engr110-2026-obstacle-detector/pcb/front/renders/front_back.png

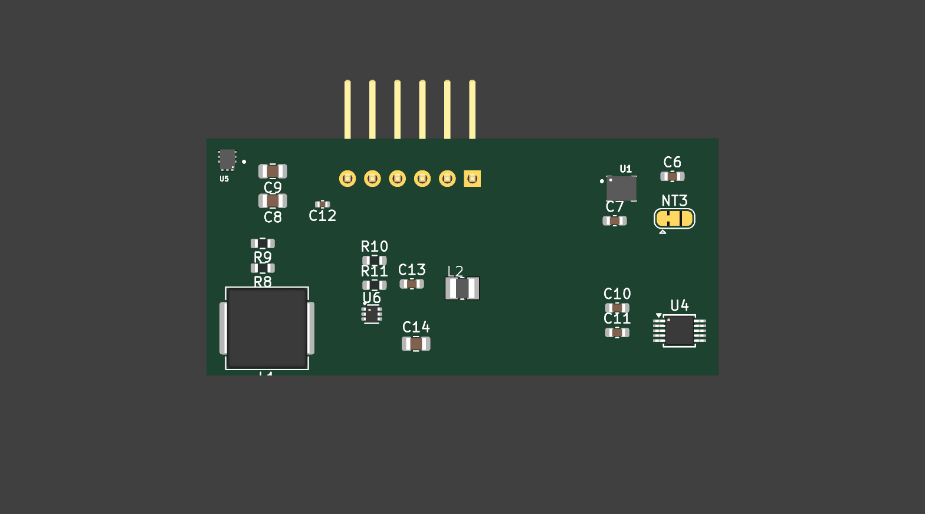
front/renders/front_back.png
