engr110-2026-obstacle-detector/pcb/front/renders/front_sensor_C.png

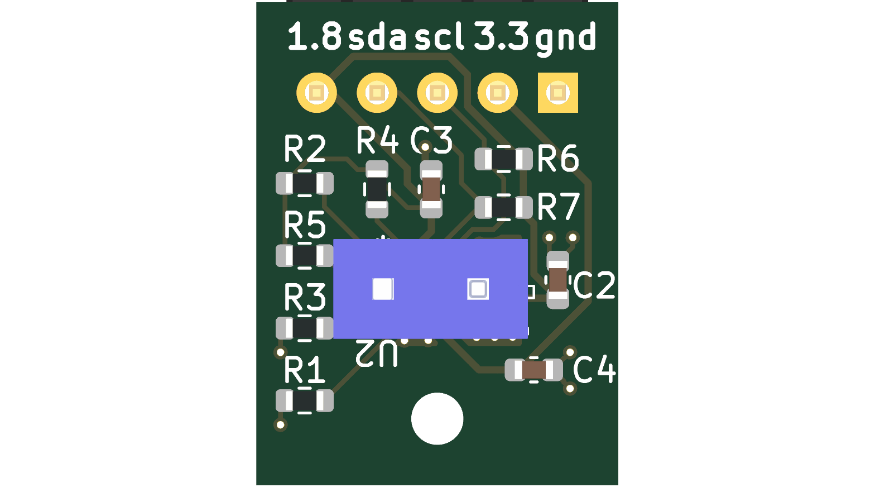
front/renders/front_sensor_C.png
