engr110-2026-obstacle-detector/pcb/front/renders/front_top.png

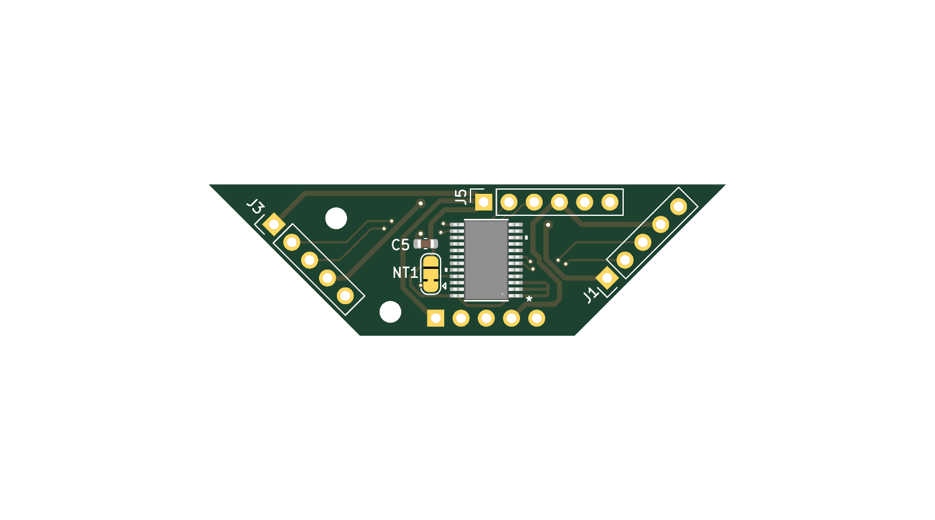
front/renders/front_top.png
