engr110-2026-obstacle-detector/pcb/front/renders/panel.png

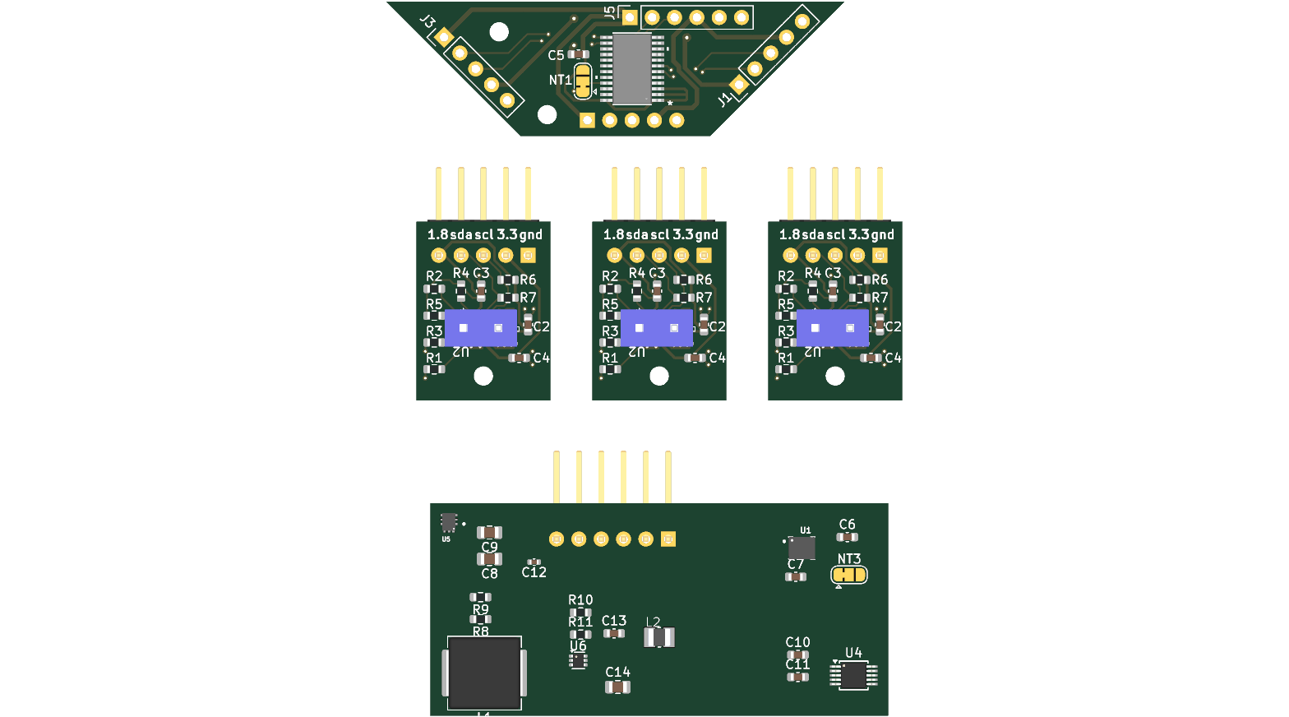
front/renders/panel.png
