engr110-2026-obstacle-detector/pcb/front/3d_models/front_assembly.step

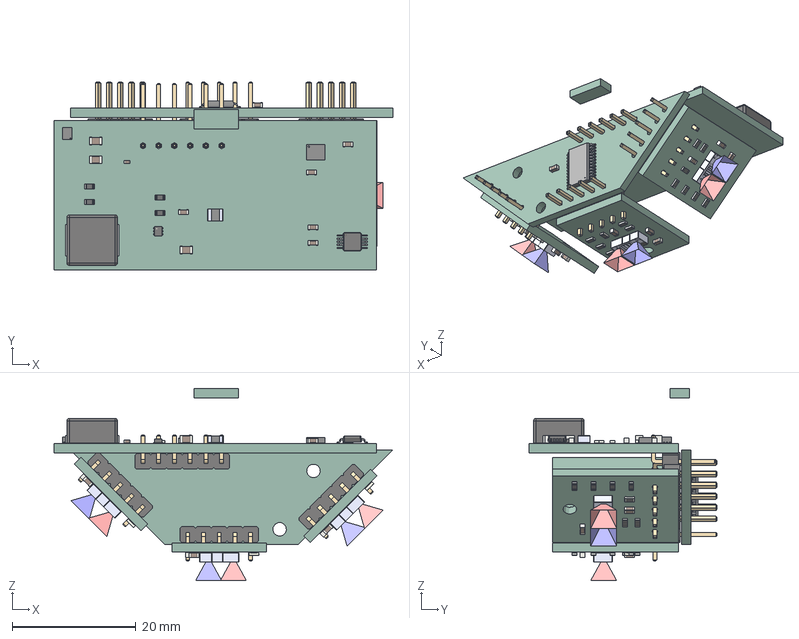
[picture p5: CAD file, 2026-04-03]
front/3d_models/front_assembly.step
54.7 x 30.4 x 31.0 mm
C_0603_1608Metric x 15
TSSOP-10_3x3mm_P0.5mm
SOT-563
L_Vishay_IHLP-3232
R_0603_1608Metric x 25
DFE252012F-1R0M=P2
C_0805_2012Metric x 3
TPS62902RPJR--3DModel-STEP-418109
C_0402_1005Metric
LSM6DSO32TR
PinHeader_1x06_P2.54mm_Horizontal
front_back_PCB
VL53L8 SUBSTRATE x 3
VL53L8 CAP x 3
VL53L8 Rx Exclusion Cone x 3
VL53L8 Tx Exclusion Cone x 3
PinHeader_1x05_P2.54mm_Horizontal x 3
front_sensor_C_PCB x 3
TSSOP24_SOT355-1_NEX_NXP
front_top_PCB
front-assembly_PCB
