engr110-2026-obstacle-detector/pcb/front/3d_models/stencil.step

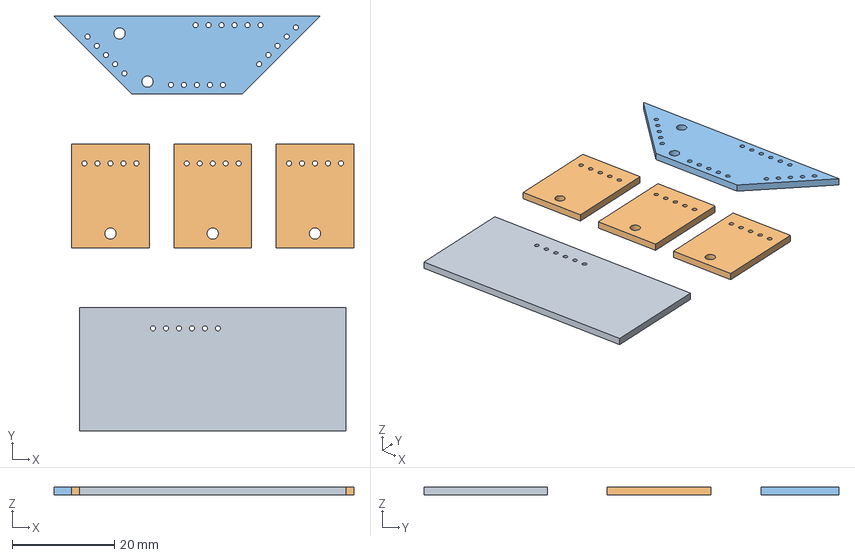
[picture p6: CAD file, 2026-04-03]
front/3d_models/stencil.step
58.7 x 81.1 x 1.51 mm
PANEL_PCB_1
PANEL_PCB_2
PANEL_PCB_3
PANEL_PCB_4
PANEL_PCB_5
