engr110-2026-obstacle-detector/pcb/front/3d_models/front_sensor.step

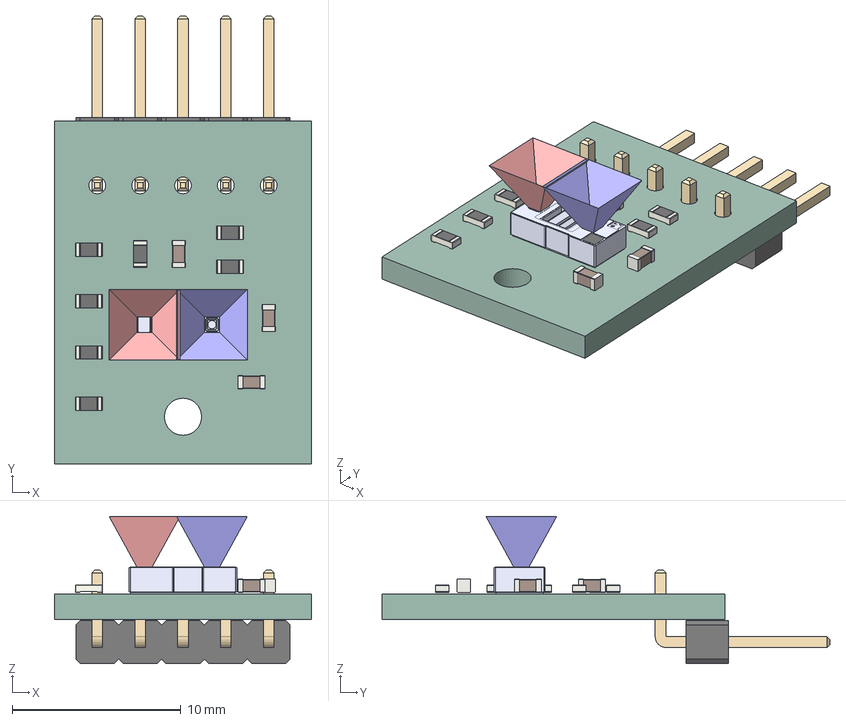
[picture p7: CAD file, 2026-04-03]
front/3d_models/front_sensor.step
15.2 x 26.6 x 8.72 mm
R_0603_1608Metric x 7
C_0603_1608Metric x 3
VL53L8 SUBSTRATE
VL53L8 CAP
VL53L8 Rx Exclusion Cone
VL53L8 Tx Exclusion Cone
PinHeader_1x05_P2.54mm_Horizontal
front_sensor_C_PCB
