engr110-2026-obstacle-detector/pcb/front/3d_models/front_top.step

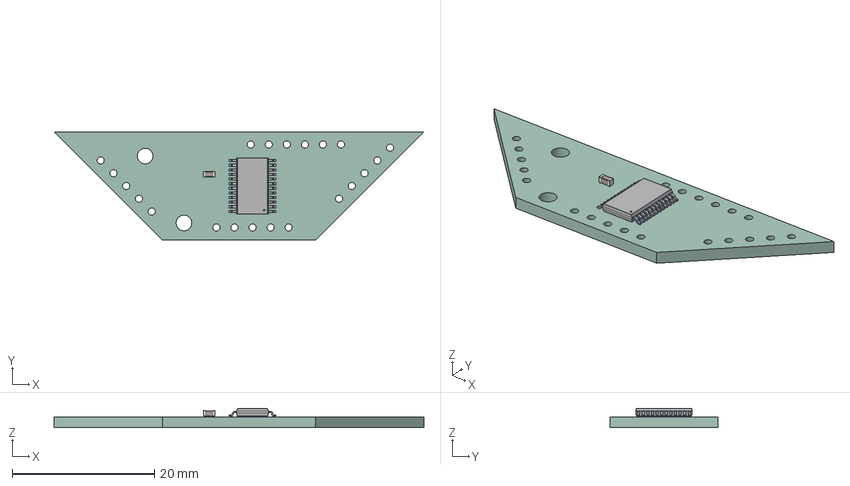
[picture p8: CAD file, 2026-04-03]
front/3d_models/front_top.step
52.1 x 15.2 x 2.69 mm
C_0603_1608Metric
TSSOP24_SOT355-1_NEX_NXP
front_top_PCB
