engr110-2026-obstacle-detector/pcb/front/3d_models/front_back.step

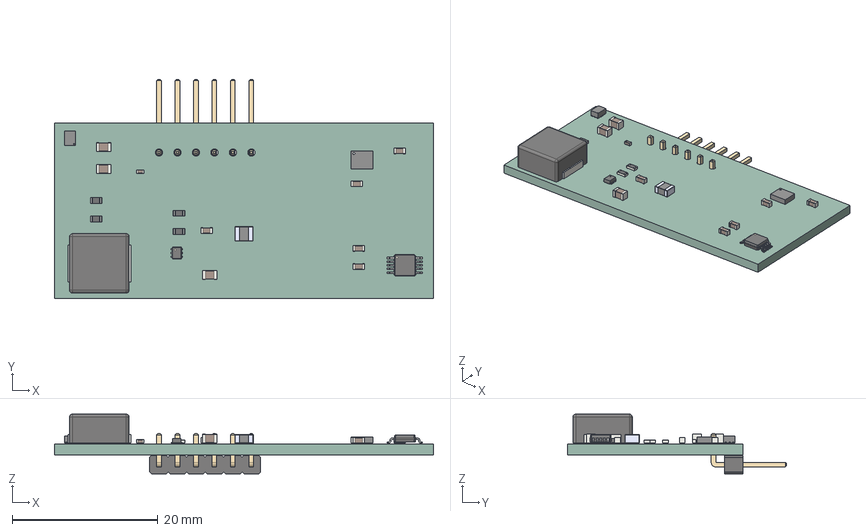
[picture p9: CAD file, 2026-04-03]
front/3d_models/front_back.step
52.1 x 30.1 x 8.22 mm
C_0603_1608Metric x 5
TSSOP-10_3x3mm_P0.5mm
SOT-563
L_Vishay_IHLP-3232
R_0603_1608Metric x 4
DFE252012F-1R0M=P2
C_0805_2012Metric x 3
TPS62902RPJR--3DModel-STEP-418109
C_0402_1005Metric
LSM6DSO32TR
PinHeader_1x06_P2.54mm_Horizontal
front_back_PCB
