engr110-2026-obstacle-detector/pcb/(list of files, cad)

Other CAD files:
front/3d_models/front_back.stl
front/3d_models/front_sensor.stl
front/3d_models/front_top.stl
front/3d_models/stencil.stl
