engr110-2026-obstacle-detector/pcb/central/central.kicad_pcb

## KiCad design central/central.kicad_pcb (2026-05-24)

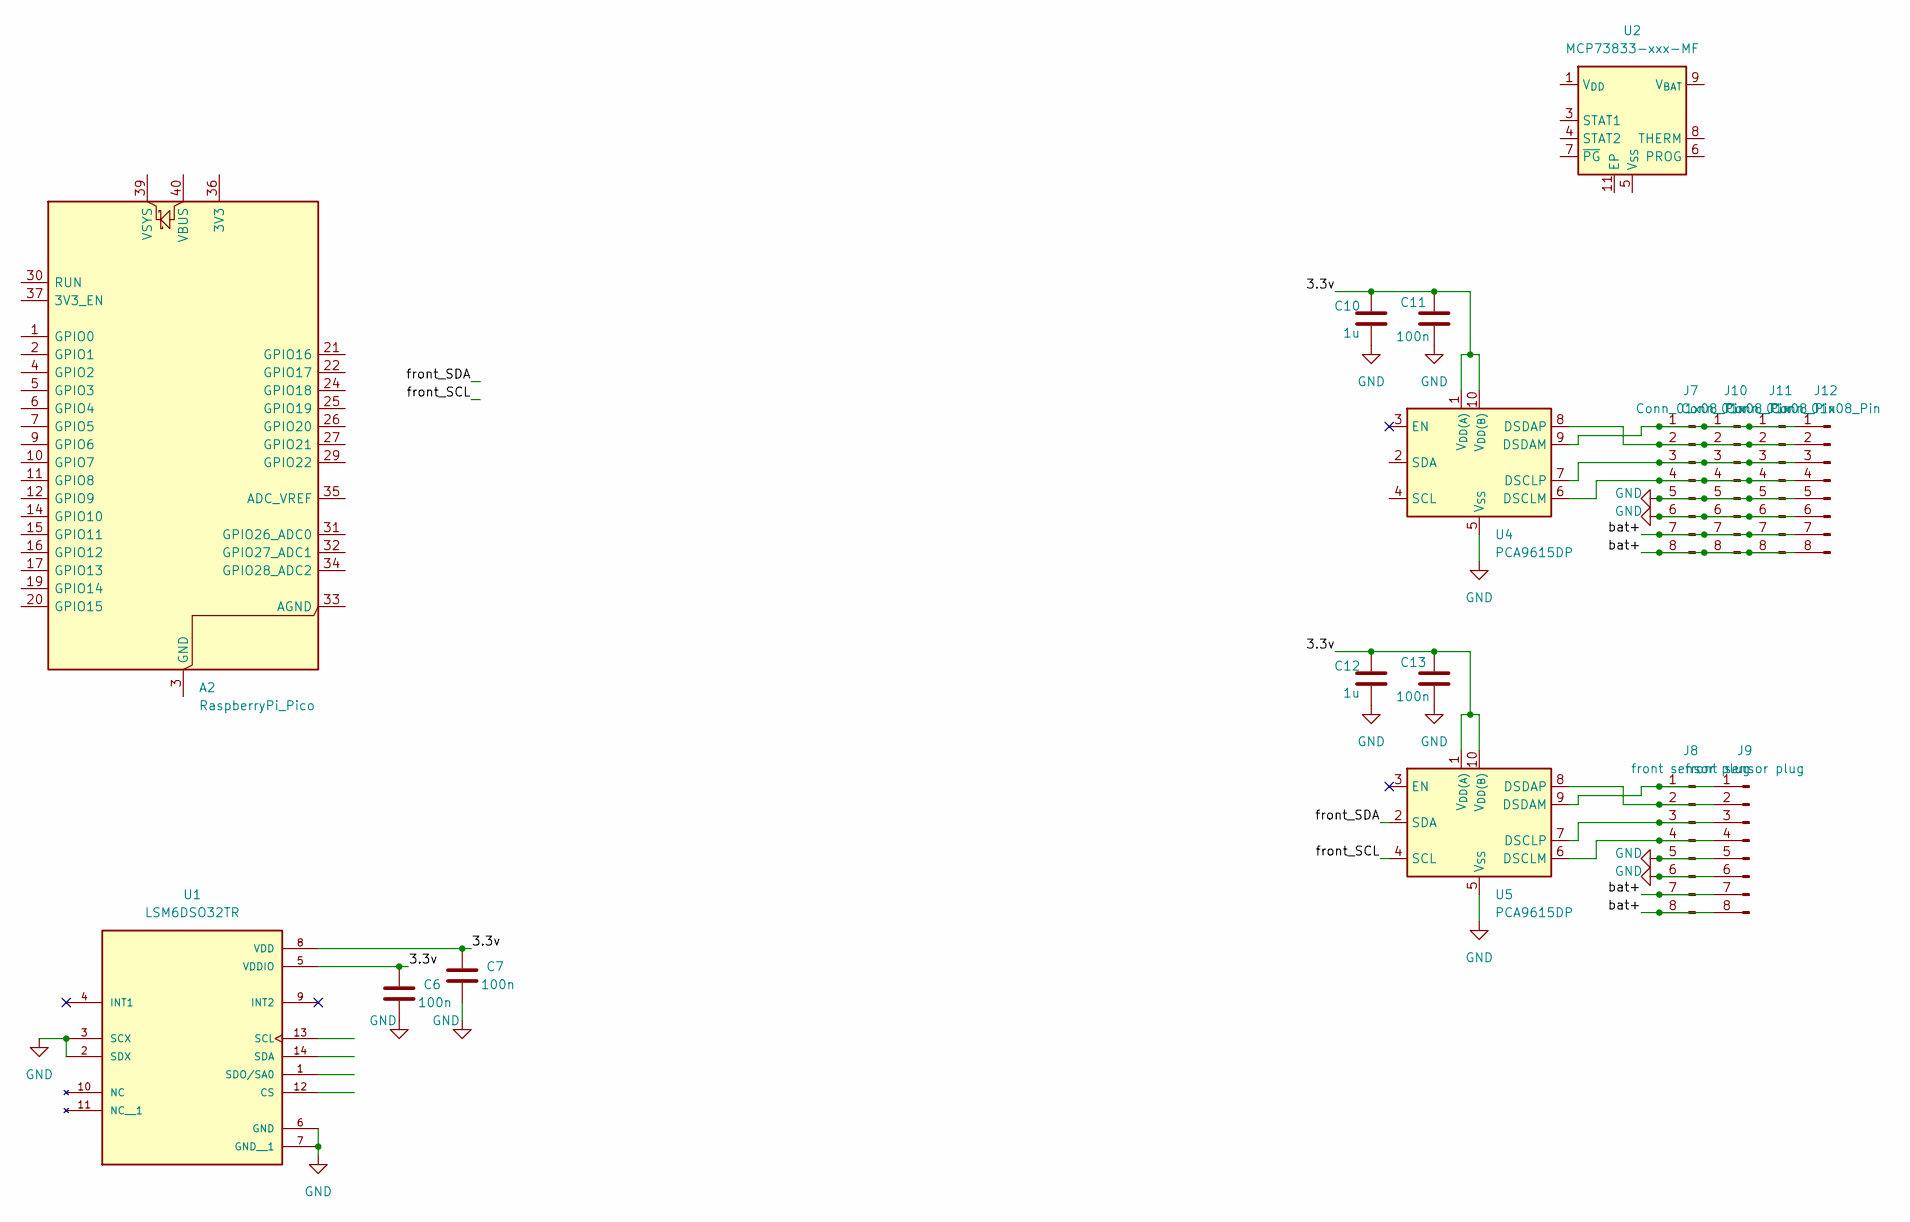
[picture p10: schematic central.kicad_sch]

Parts:
A2: RaspberryPi_Pico; RaspberryPi_Pico_Common_Unspecified
C6, C7, C11, C13: 100n; C_0603_1608Metric
C10, C12: 1u; C_0603_1608Metric
J7, J10, J11, J12: Conn_01x08_Pin; JST_XH_B8B-XH-AM_1x08_P2.50mm_Vertical
J8, J9: front sensor plug; JST_XH_B8B-XH-AM_1x08_P2.50mm_Vertical
U1: LSM6DSO32TR; XDCR_LSM6DSO32TR; PARTREV 1
U2: MCP73833-xxx-MF; DFN-10-1EP_3x3mm_P0.5mm_EP1.58x2.35mm
U4, U5: PCA9615DP; TSSOP-10_3x3mm_P0.5mm

Connections:
/3.3v: C6.1, C7.1, C10.1, C11.1, C12.1, C13.1, U1.5 (VDDIO), U1.8 (VDD), U4.1 (V_{DD(A)}), U4.10 (V_{DD(B)}), U5.1 (V_{DD(A)}), U5.10 (V_{DD(B)})
/bat+: J7.7, J7.8, J8.7, J8.8, J9.7, J9.8, J10.7, J10.8, J11.7, J11.8, J12.7, J12.8
/front_SCL: U5.4 (SCL)
/front_SDA: U5.2 (SDA)
GND: C6.2, C7.2, C10.2, C11.2, C12.2, C13.2, J7.5, J7.6, J8.5, J8.6, J9.5, J9.6, J10.5, J10.6, J11.5, J11.6, J12.5, J12.6, U1.2 (SDX), U1.3 (SCX), U1.6 (GND), U1.7 (GND__1), U4.5 (V_{SS}), U5.5 (V_{SS})
unnamed: A2.3 (GND), A2.8 (GND), A2.13 (GND), A2.18 (GND), A2.23 (GND), A2.28 (GND), A2.38 (GND)
unnamed: J8.1, J9.1, U5.9 (DSDAM)
unnamed: J8.2, J9.2, U5.8 (DSDAP)
unnamed: J8.3, J9.3, U5.7 (DSCLP)
unnamed: J8.4, J9.4, U5.6 (DSCLM)
unnamed: J7.1, J10.1, J11.1, J12.1, U4.9 (DSDAM)
unnamed: J7.2, J10.2, J11.2, J12.2, U4.8 (DSDAP)
unnamed: J7.3, J10.3, J11.3, J12.3, U4.7 (DSCLP)
unnamed: J7.4, J10.4, J11.4, J12.4, U4.6 (DSCLM)
unnamed: U2.1 (V_{DD}), U2.2 (V_{DD})
unnamed: U2.9 (V_{BAT}), U2.10 (V_{BAT})

Board: 2 copper layers, 16 parts (0 on the bottom side), 12 nets, no tracks yet.
