engr110-2026-obstacle-detector/pcb/front/front.kicad_pcb

## KiCad design front/front.kicad_pcb (2026-05-24)

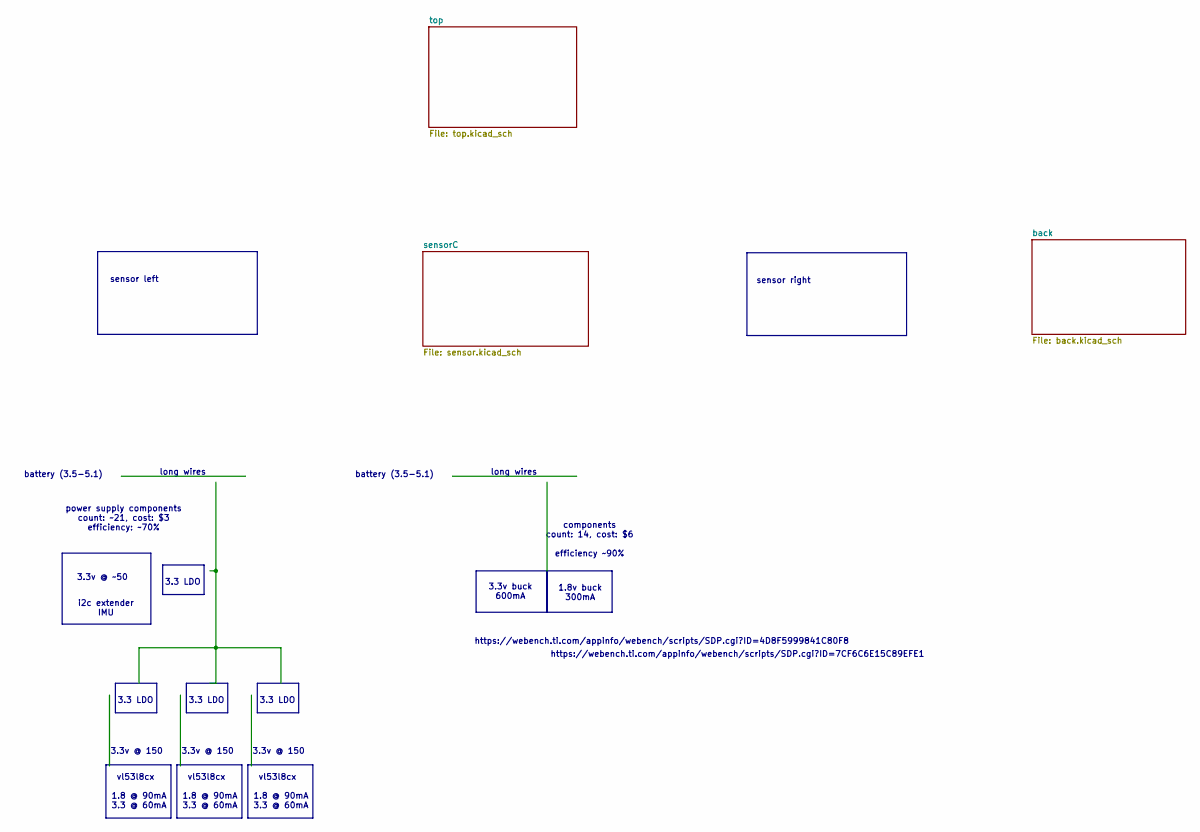
[picture p11: schematic front.kicad_sch]

Notes on the sheet:
1.8 @ 90mA 3.3 @ 60mA
power supply components count: ~21, cost: $3 efficiency: ~70%
vl53l8cx
3.3 LDO
sensor right
battery (3.5-5.1)
3.3v @ ~50
3.3v @ 150
https://webench.ti.com/appinfo/webench/scripts/SDP.cgi?ID=7CF6C6E15C89EFE1
3.3v buck 600mA
https://webench.ti.com/appinfo/webench/scripts/SDP.cgi?ID=4D8F5999841C80F8
long wires
sensor left
i2c extender IMU
components count: 14, cost: $6 efficiency ~90%
1.8v buck 300mA

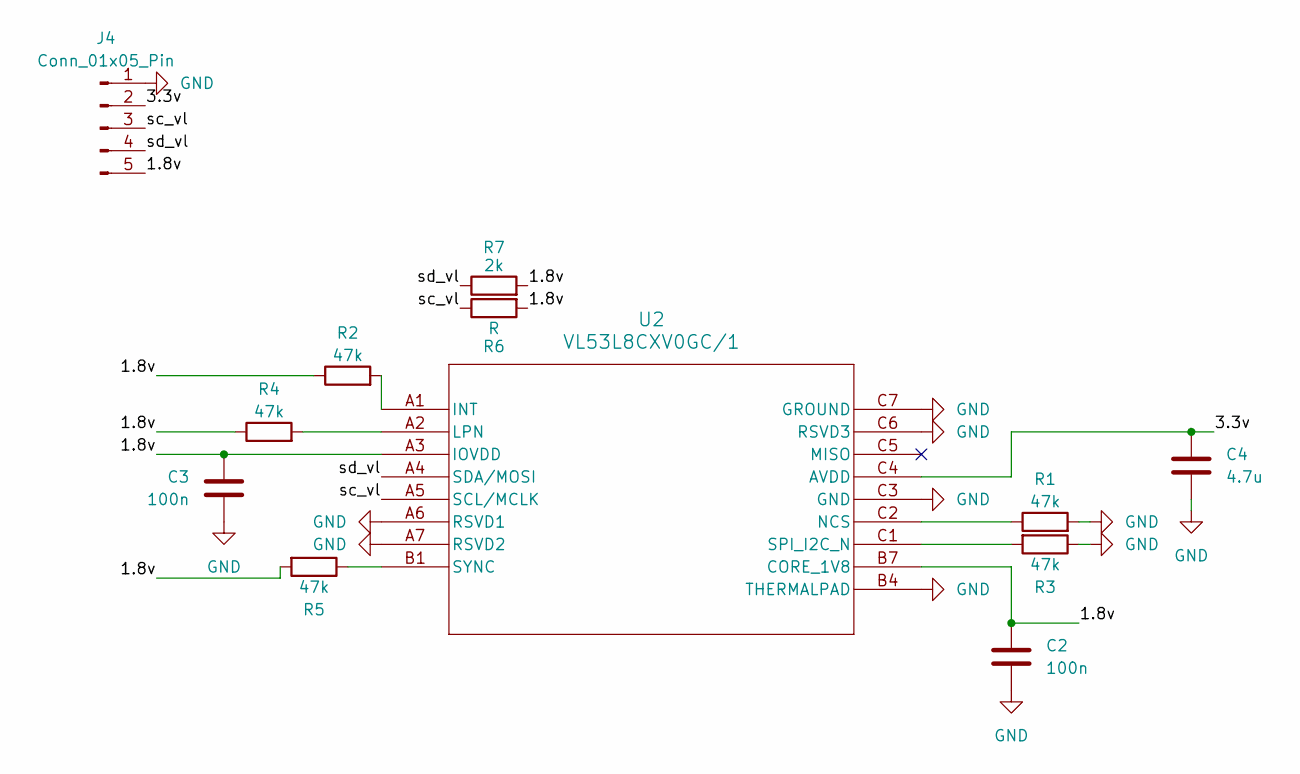
[picture p12: schematic sensor.kicad_sch]

Parts:
C2, C3: 100n; C_0603_1608Metric
C4: 4.7u; C_0603_1608Metric
J4: Conn_01x05_Pin; PinHeader_1x05_P2.54mm_Horizontal
R1, R2, R3, R4, R5: 47k; R_0603_1608Metric
R6: R; R_0603_1608Metric
R7: 2k; R_0603_1608Metric
U2: VL53L8CXV0GC/1; IC17_LGA16_STM

Connections:
/sensorC/1.8v: C2.1, C3.1, J4.5, R2.1, R4.1, R5.2, R6.2, R7.2, U2.A3 (IOVDD), U2.B7 (CORE_1V8)
/sensorC/3.3v: C4.1, J4.2, U2.C4 (AVDD)
/sensorC/sc_vl: J4.3, R6.1, U2.A5 (SCL/MCLK)
/sensorC/sd_vl: J4.4, R7.1, U2.A4 (SDA/MOSI)
GND: C2.2, C3.2, C4.2, J4.1, R1.2, R3.1, U2.A6 (RSVD1), U2.A7 (RSVD2), U2.B4 (THERMALPAD), U2.C3 (GND), U2.C6 (RSVD3), U2.C7 (GROUND); also elsewhere on the board
unnamed: R2.2, U2.A1 (INT)
unnamed: R4.2, U2.A2 (LPN)
unnamed: R1.1, U2.C2 (NCS)
unnamed: R3.2, U2.C1 (SPI_I2C_N)
unnamed: R5.1, U2.B1 (SYNC)

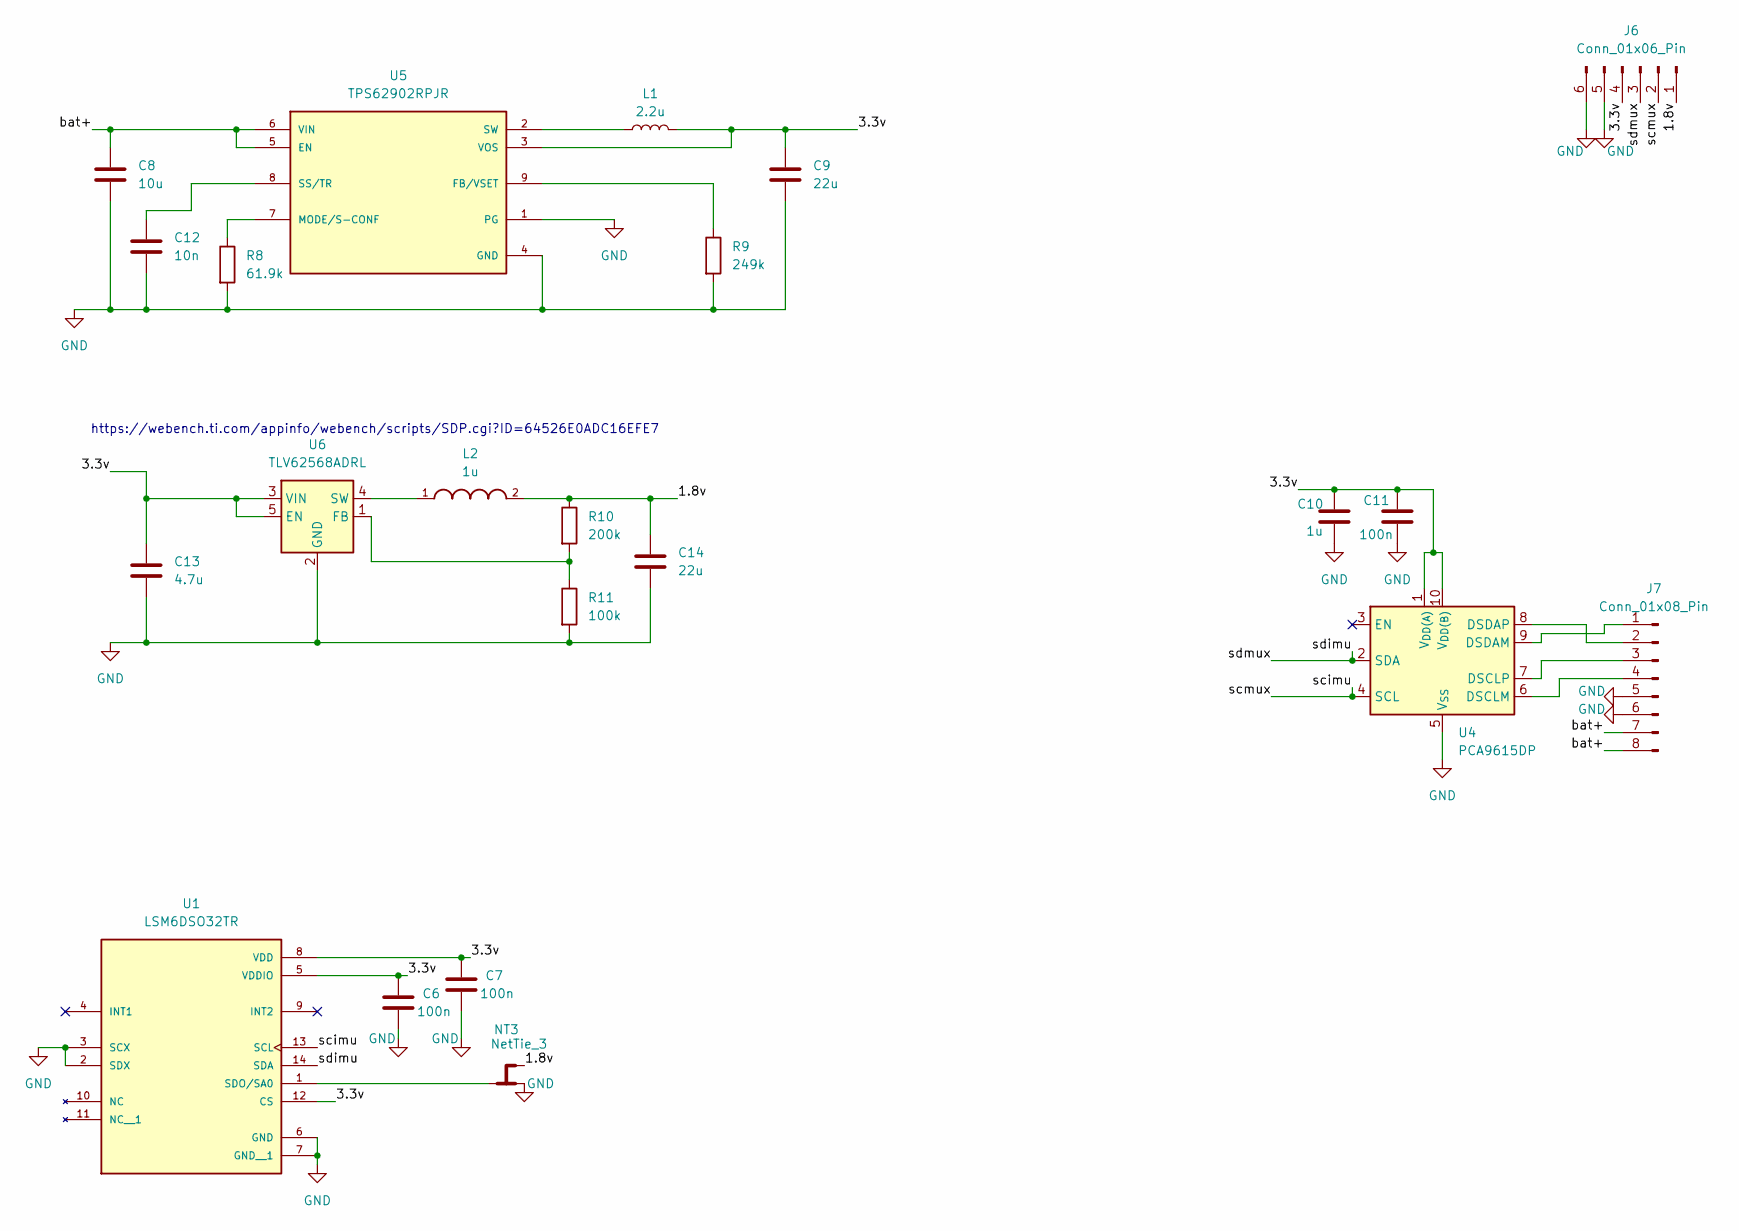
[picture p13: schematic back.kicad_sch]

Parts:
C6, C7, C11: 100n; C_0603_1608Metric
C8: 10u; C_0805_2012Metric; Mfr PN MSAST21GBB5106MTNA01
C9, C14: 22u; C_0805_2012Metric; Mfr PN GRM21BD70J226ME44L
C10: 1u; C_0603_1608Metric
C12: 10n; C_0603_1608Metric; Mfr PN GRM1857U1A103JA44D
C13: 4.7u; C_0603_1608Metric; Mfr PN C1608X7S1A475K080AC
J6: Conn_01x06_Pin; PinHeader_1x06_P2.54mm_Horizontal
J7: Conn_01x08_Pin; JST_XH_B8B-XH-AM_1x08_P2.50mm_Vertical
L1: 2.2u; WE-XHMI_4020; Mfr PN 74439323022
L2: 1u; INDC2520X120N; DigiKey_Part_Number 490-13053-1-ND
NT3: NetTie_3; SolderJumper-3_P1.3mm_Bridged12_RoundedPad1.0x1.5mm
R8: 61.9k; R_0603_1608Metric; Mfr PN CRCW060361K9FKEA
R9: 249k; R_0603_1608Metric; Mfr PN CRCW0603249KFKEA
R10: 200k; R_0603_1608Metric; Mfr PN CRCW0603200KFKEA
R11: 100k; R_0603_1608Metric; Mfr PN CRCW0603100KFKEA
U1: LSM6DSO32TR; XDCR_LSM6DSO32TR; PARTREV 1
U4: PCA9615DP; TSSOP-10_3x3mm_P0.5mm
U5: TPS62902RPJR; IC_TPS62902RPJR; PARTREV March 2021; DigiKey_Part_Number 296-TPS62902RPJRCT-ND
U6: TLV62568ADRL; SOT-563

Connections:
/back/1.8v: C14.1, J6.1, L2.2, NT3.3, R10.1
/back/3.3v: C6.1, C7.1, C9.1, C10.1, C11.1, C13.1, J6.4, L1.2, U1.5 (VDDIO), U1.8 (VDD), U1.12 (CS), U4.1 (V_{DD(A)}), U4.10 (V_{DD(B)}), U5.3 (VOS), U6.3 (VIN), U6.5 (EN)
/back/bat+: C8.1, J7.7, J7.8, U5.5 (EN), U5.6 (VIN)
/back/scimu: J6.2, U1.13 (SCL), U4.4 (SCL)
/back/sdimu: J6.3, U1.14 (SDA), U4.2 (SDA)
GND: C6.2, C7.2, C8.2, C9.2, C10.2, C11.2, C12.2, C13.2, C14.2, J6.5, J6.6, J7.5, J7.6, NT3.1, R8.2, R9.2, R11.2, U1.2 (SDX), U1.3 (SCX), U1.6 (GND), U1.7 (GND__1), U4.5 (V_{SS}), U5.1 (PG), U5.4 (GND), U6.2 (GND); also elsewhere on the board
unnamed: J7.1, U4.9 (DSDAM)
unnamed: J7.2, U4.8 (DSDAP)
unnamed: J7.3, U4.7 (DSCLP)
unnamed: J7.4, U4.6 (DSCLM)
unnamed: NT3.2, U1.1 (SDO/SA0)
unnamed: R9.1, U5.9 (FB/VSET)
unnamed: R8.1, U5.7 (MODE/S-CONF)
unnamed: C12.1, U5.8 (SS/TR)
unnamed: L1.1, U5.2 (SW)
unnamed: R10.2, R11.1, U6.1 (FB)
unnamed: L2.1, U6.4 (SW)

Notes on the sheet:
https://webench.ti.com/appinfo/webench/scripts/SDP.cgi?ID=64526E0ADC16EFE7

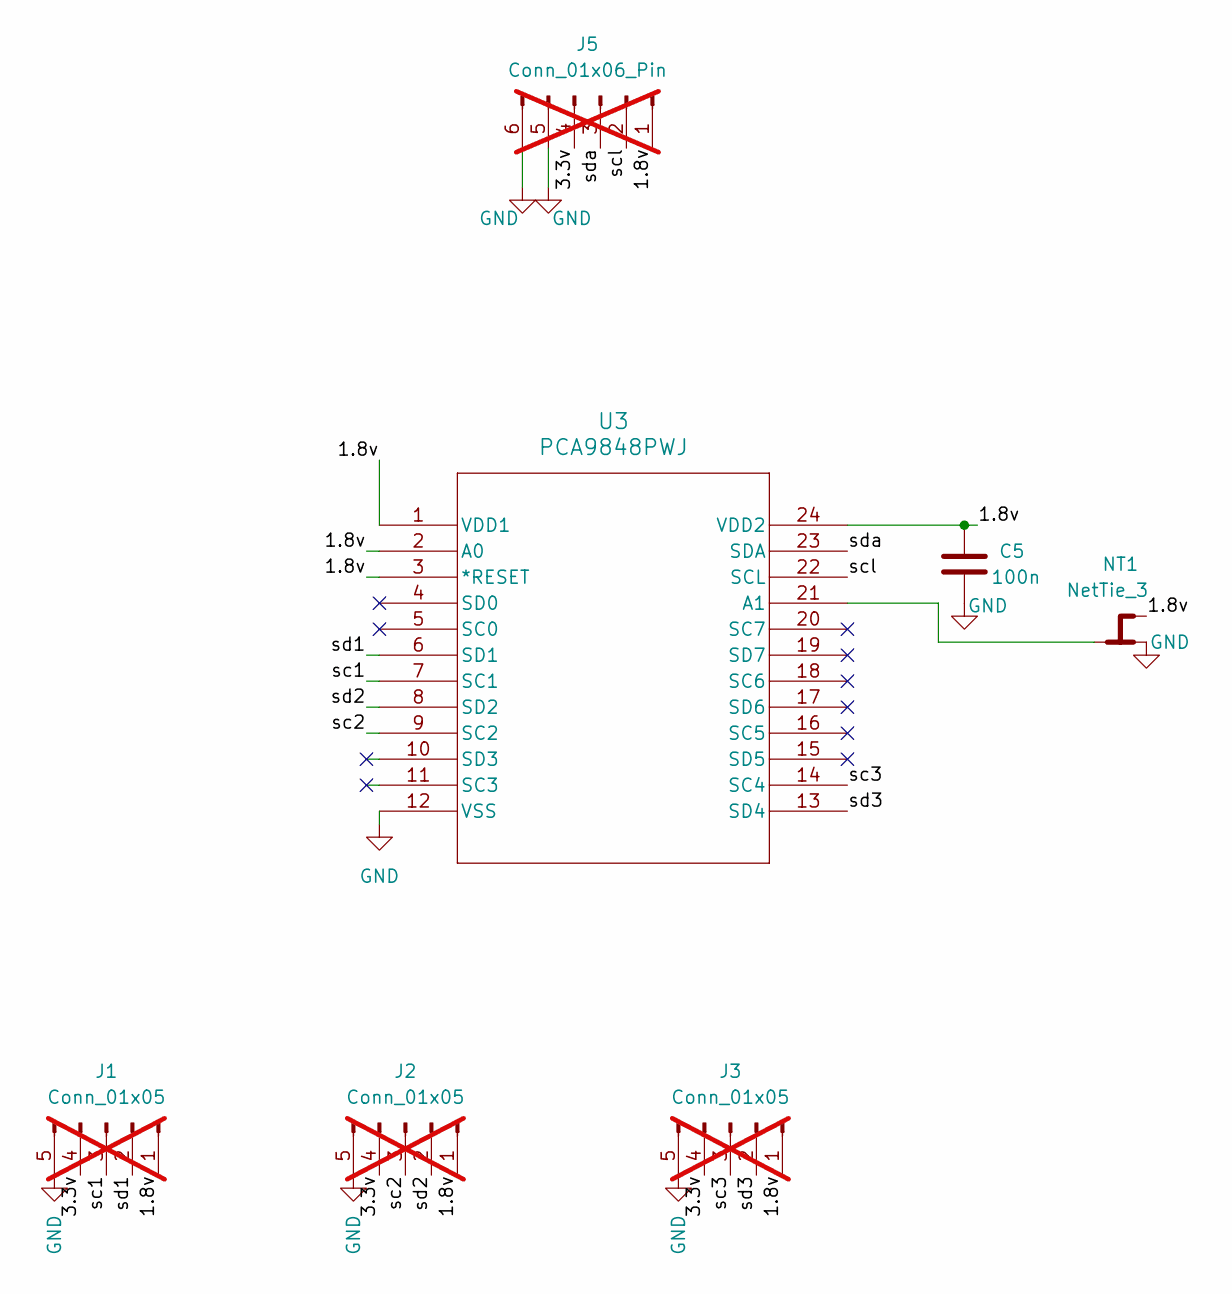
[picture p14: schematic top.kicad_sch]

Parts:
C5: 100n; C_0603_1608Metric
J1, J2, J3: Conn_01x05; PinHeader_1x05_P2.54mm_Vertical; not fitted
J5: Conn_01x06_Pin; PinSocket_1x06_P2.54mm_Vertical; not fitted
NT1: NetTie_3; SolderJumper-3_P1.3mm_Bridged12_RoundedPad1.0x1.5mm
U3: PCA9848PWJ; TSSOP24_SOT355-1_NEX_NXP

Connections:
/top/1.8v: C5.1, J1.1, J2.1, J3.1, J5.1, NT1.3, U3.1 (VDD1), U3.2 (A0), U3.3 (*RESET), U3.24 (VDD2)
/top/3.3v: J1.4, J2.4, J3.4, J5.4
/top/sc1: J1.3, U3.7 (SC1)
/top/sc2: J2.3, U3.9 (SC2)
/top/sc3: J3.3, U3.14 (SC4)
/top/scl: J5.2, U3.22 (SCL)
/top/sd1: J1.2, U3.6 (SD1)
/top/sd2: J2.2, U3.8 (SD2)
/top/sd3: J3.2, U3.13 (SD4)
/top/sda: J5.3, U3.23 (SDA)
GND: C5.2, J1.5, J2.5, J3.5, J5.5, J5.6, NT1.1, U3.12 (VSS); also elsewhere on the board
unnamed: NT1.2, U3.21 (A1)

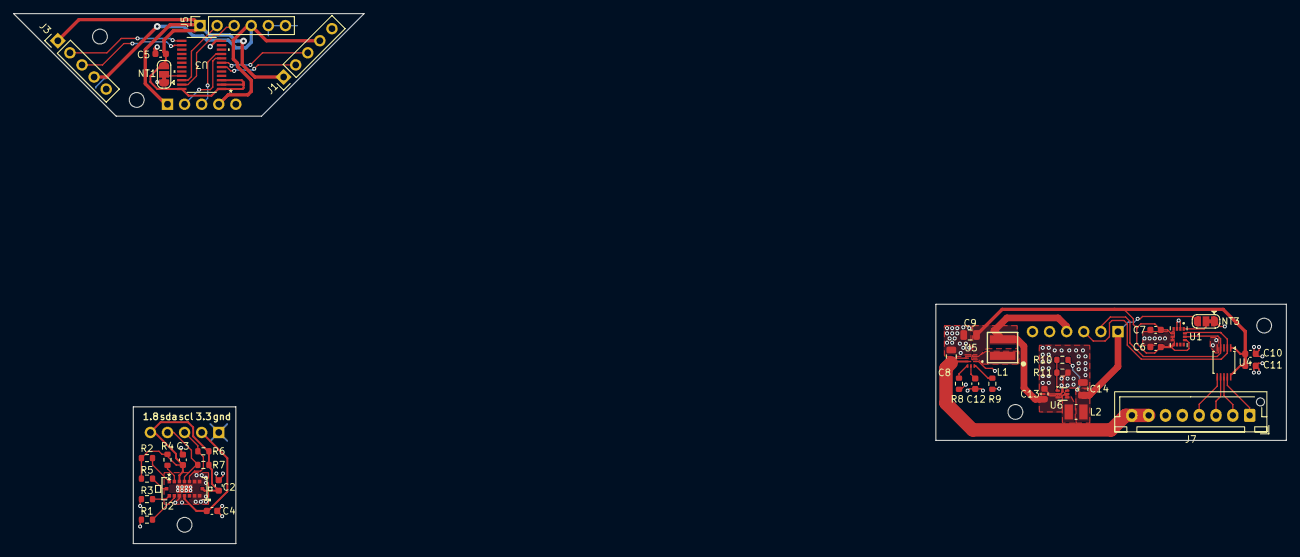
[picture p15: board front.kicad_pcb from above]

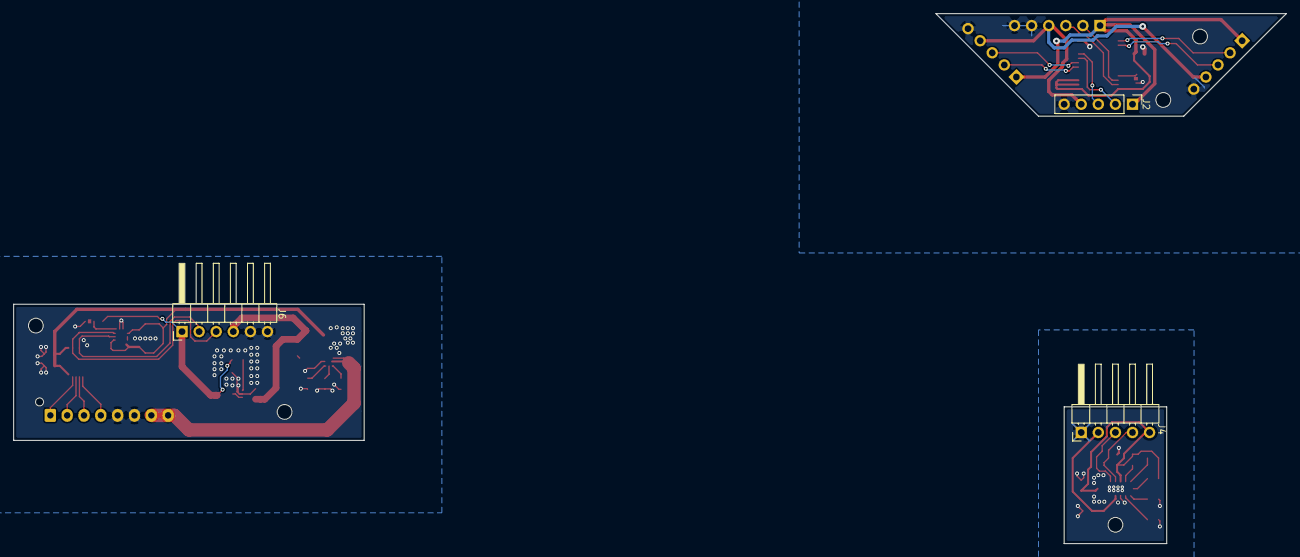
[picture p16: board front.kicad_pcb from below]

Board: 2 copper layers, 189.1 x 78.7 mm, 41 parts (3 on the bottom side), 37 nets.
