engr110-2026-obstacle-detector/pcb/(commit log)

2026-03-19 start adding components
    [back.kicad_sch, bottom.kicad_sch, core.kicad_sch, front-core.kicad_pcb, front-imu.kicad_pcb, front.kicad_pcb, front.kicad_sch, imu.kicad_sch]
2026-03-21 script panelizes
    [front.kicad_pcb, panel_F_SolderPasteMask.dxf]
2026-03-21 render images
    [panel_F_SolderPasteMask.dxf]
2026-03-21 add step files
    [front_back.step, front_bottom.step, front_sensor.step, front_top.step]
2026-03-21 add stls
    [front_back.step, front_back.stl, front_bottom.step, front_bottom.stl, front_sensor.step, front_sensor.stl, front_top.step, front_top.stl]
2026-03-21 add some traces
    [back.kicad_sch, bottom.kicad_sch, front.kicad_pcb, front_back.step, front_bottom.step, front_sensor.step, front_top.step, sensor.kicad_sch]
2026-03-21 undo panelizing
    [back.kicad_sch, front.kicad_pcb, front.kicad_sch, front_back.step, front_back.stl, front_bottom.step, front_bottom.stl, front_sensor.step]
2026-03-21 run script
    [front_back.step, front_sensor.step, front_top.step, front_top.stl, stencil.step]
2026-03-23 add more components
    [front.kicad_pcb, front_back.step, front_sensor.step, front_sensor.stl, front_top.step, front_top.stl, sensor.kicad_sch, stencil.step]
2026-03-30 begin layout
    [back.kicad_sch, bottom.kicad_sch, front-assembly.kicad_pcb, front.kicad_pcb, front.kicad_sch, front_assembly.step, front_back.step, front_back.stl]
2026-04-03 layout front top
    [front-assembly.kicad_pcb, front.kicad_pcb, front_assembly.step, front_back.step, front_back.stl, front_sensor.step, front_sensor.stl, front_top.step]
2026-05-24 push changes
    [back.kicad_sch, central.kicad_pcb, central.kicad_sch, front.kicad_pcb, sensor.kicad_sch]
